jmercerr/CW312T-ESP32/KiCAD_Test3.kicad_pcb

## KiCad design KiCAD_Test3.kicad_pcb (2024-12-19)

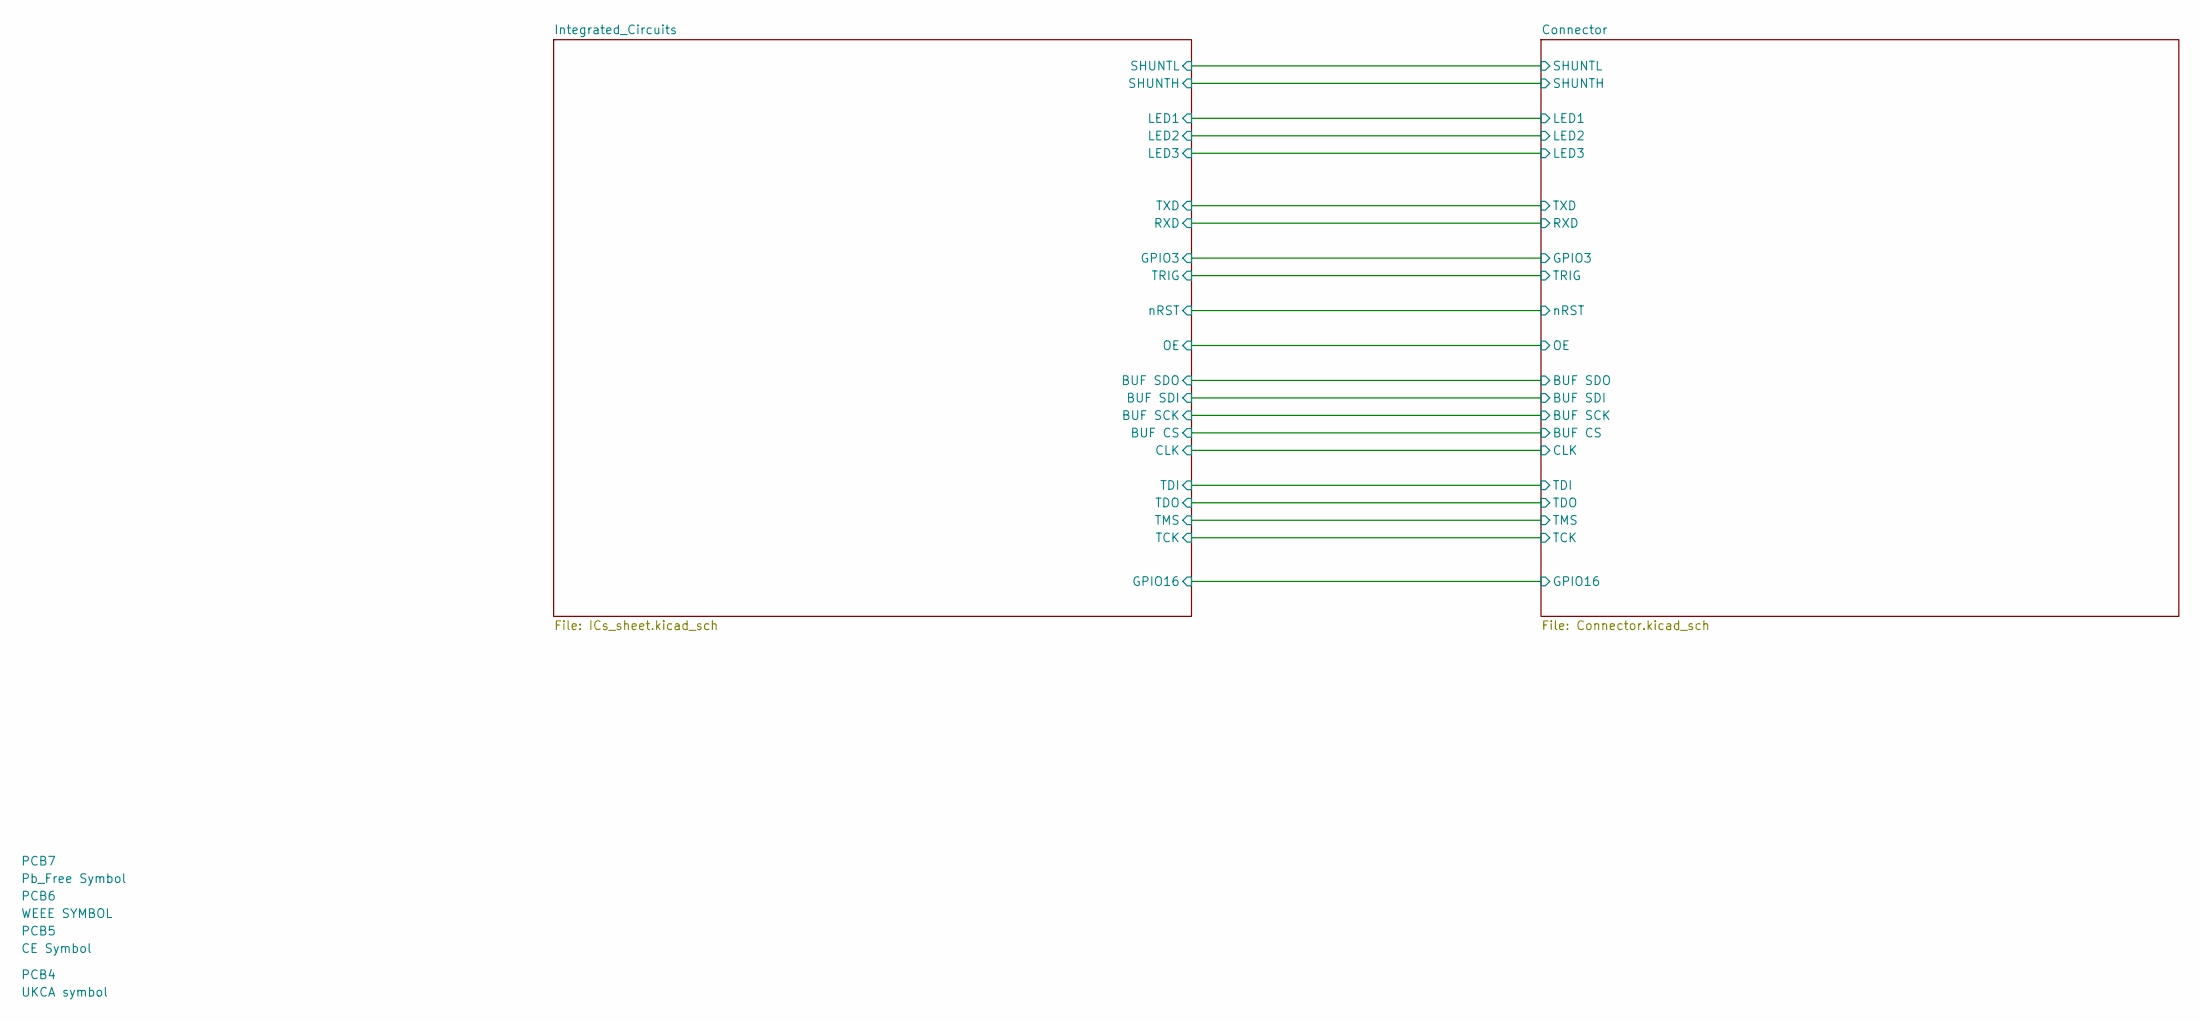
[picture p1: schematic KiCAD_Test3.kicad_sch]

Parts:
PCB4: UKCA symbol; UKCA-Logo_8x8mm_SilkScreen
PCB5: CE Symbol; CE-Logo_8.5x6mm_SilkScreen
PCB6: WEEE SYMBOL; WEEE-Logo_5.6x8mm_SilkScreen
PCB7: Pb_Free Symbol; Pb_Free_8.0x8.0mm_SilkScreen

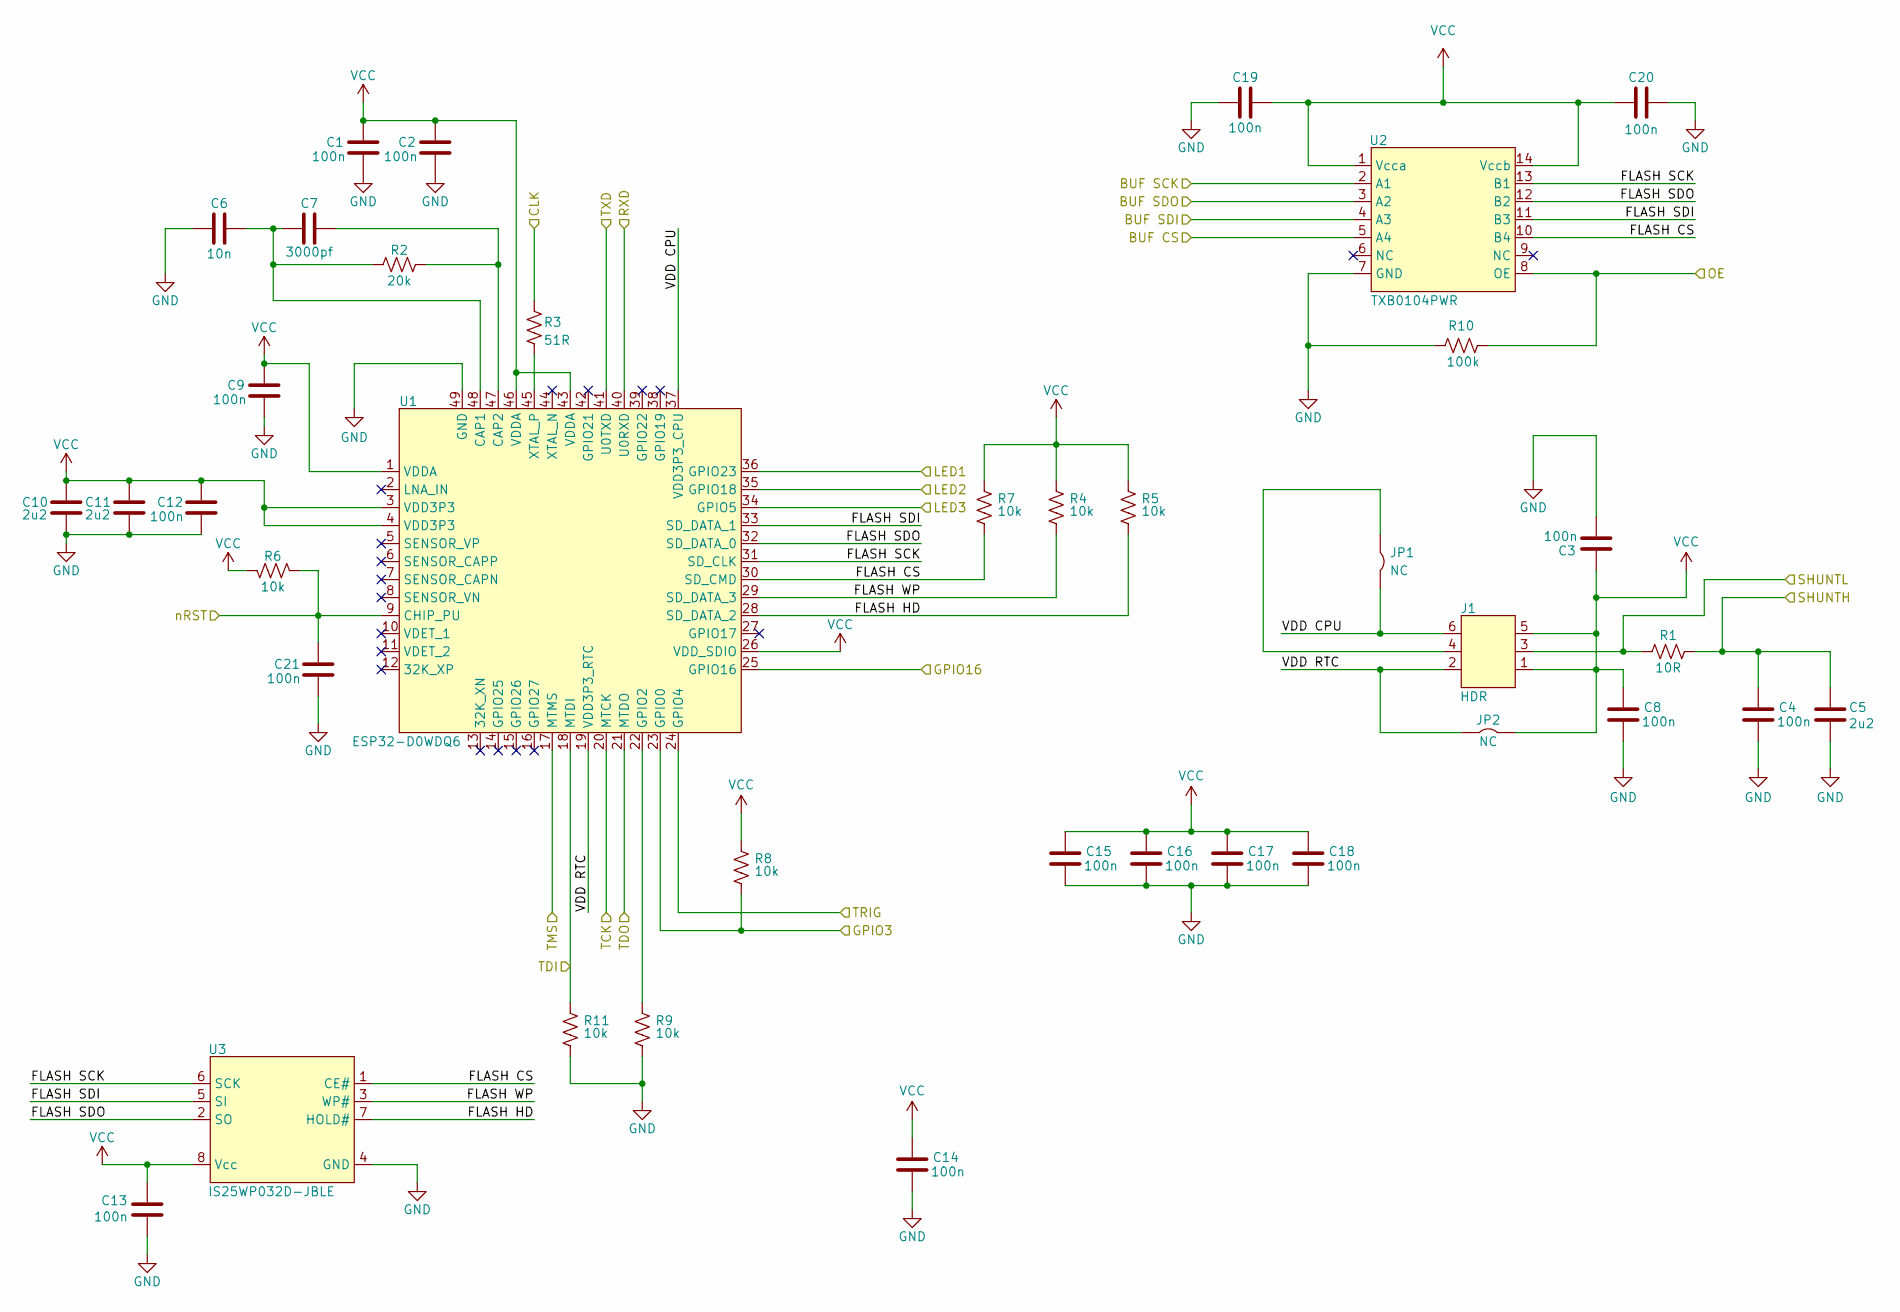
[picture p2: schematic ICs_sheet.kicad_sch]

Parts:
C1, C2, C3, C4, C8, C9, C12, C13, C14, C15, C16, C17, C18, C19, C20, C21: CAP_100n_6.3V_0603; C_0603_1608Metric; Manufacturer Part Number CC0603KRX7R5BB104
C5, C10, C11: CAP_2u2_6.3V_0603; C_0603_1608Metric; Manufacturer Part Number CC0603KRX7R5BB225
C6: CAP_10n_10V_0603; C_0603_1608Metric; Manufacturer Part Number CC0603KRX7R6BB103
C7: CAP_3000p_50V_0603; C_0603_1608Metric; Manufacturer Part Number CC0603JRNPO9BN302
J1: HDR_6_2.54; PinHeader_2x03_P2.54mm_Vertical; Manufacturer Part Number PH2-06-UA
JP1, JP2: SolderJumper-2_P1.3mm_Bridged2Bar_Pad1.0x1.5mm
R1: RES_10R_0603; R_0603_1608Metric; Manufacturer Part Number RC0603FR-0710RL
R2: RES_20k_0603; R_0603_1608Metric; Manufacturer Part Number RC0603FR-0720KL
R3: RES_51R_0603; R_0603_1608Metric; Manufacturer Part Number RC0603FR-0751RL
R4, R5, R6, R7, R8, R9, R11: RES_10k_0603; R_0603_1608Metric; Manufacturer Part Number RC0603FR-0710KL
R10: RES_100k_0603; R_0603_1608Metric; Manufacturer Part Number RC0603FR-07100KL
U1: ESP32-D0WDQ6; QFN-48-1EP_6x6mm_P0.4mm_EP4.3x4.3mm; Manufacturer Part Number ESP32-D0WDQ6
U2: TXB0104PWR; SOIC-14_3.9x8.7mm_P1.27mm; Manufacturer Part Number TXB0104PWR
U3: IS25WP032D; SOIC-8_5.275x5.275mm_P1.27mm; Manufacturer Part Number IS25WP032D-JBLE

Connections:
/Connector/BUF CS: U2.5 (A4); also elsewhere on the board
/Connector/BUF SCK: U2.2 (A1); also elsewhere on the board
/Connector/BUF SDI: U2.4 (A3); also elsewhere on the board
/Connector/BUF SDO: U2.3 (A2); also elsewhere on the board
/Connector/CLK: R3.2; also elsewhere on the board
/Connector/GPIO3: R8.1, U1.23 (GPIO0); also elsewhere on the board
/Connector/GPIO16: U1.25 (GPIO16); also elsewhere on the board
/Connector/LED1: U1.36 (GPIO23); also elsewhere on the board
/Connector/LED2: U1.35 (GPIO18); also elsewhere on the board
/Connector/LED3: U1.34 (GPIO5); also elsewhere on the board
/Connector/OE: R10.2, U2.8 (OE); also elsewhere on the board
/Connector/RXD: U1.40 (U0RXD); also elsewhere on the board
/Connector/SHUNTL: C4.1, C5.1, J1.3, R1.1, R1.2; also elsewhere on the board
/Connector/TCK: U1.20 (MTCK); also elsewhere on the board
/Connector/TDI: R11.2, U1.18 (MTDI); also elsewhere on the board
/Connector/TDO: U1.21 (MTDO); also elsewhere on the board
/Connector/TMS: U1.17 (MTMS); also elsewhere on the board
/Connector/TRIG: U1.24 (GPIO4); also elsewhere on the board
/Connector/TXD: U1.41 (U0TXD); also elsewhere on the board
/Connector/nRST: C21.1, R6.2, U1.9 (CHIP_PU); also elsewhere on the board
/Integrated_Circuits/FLASH CS: R7.1, U1.30 (SD_CMD), U2.10 (B4), U3.1 (CE#)
/Integrated_Circuits/FLASH HD: R5.1, U1.28 (SD_DATA_2), U3.7 (HOLD#)
/Integrated_Circuits/FLASH SCK: U1.31 (SD_CLK), U2.13 (B1), U3.6 (SCK)
/Integrated_Circuits/FLASH SDI: U1.33 (SD_DATA_1), U2.11 (B3), U3.5 (SI)
/Integrated_Circuits/FLASH SDO: U1.32 (SD_DATA_0), U2.12 (B2), U3.2 (SO)
/Integrated_Circuits/FLASH WP: R4.1, U1.29 (SD_DATA_3), U3.3 (WP#)
/Integrated_Circuits/VDD CPU: J1.6, JP1.1, U1.37 (VDD3P3_CPU)
/Integrated_Circuits/VDD RTC: J1.2, JP2.2, U1.19 (VDD3P3_RTC)
GND: C1.2, C2.2, C3.2, C4.2, C5.2, C6.1, C8.2, C9.2, C10.2, C11.2, C12.2, C13.2, C14.2, C15.2, C16.2, C17.2, C18.2, C19.2, C20.2, C21.2, R9.1, R10.1, R11.1, U1.49 (GND), U2.7 (GND), U3.4 (GND); also elsewhere on the board
unnamed: J1.4, JP1.2
unnamed: C6.2, C7.1, R2.1, U1.48 (CAP1)
unnamed: C7.2, R2.2, U1.47 (CAP2)
unnamed: R9.2, U1.22 (GPIO2)
unnamed: R3.1, U1.45 (XTAL_P)
VCC: C1.1, C2.1, C3.1, C8.1, C9.1, C10.1, C11.1, C12.1, C13.1, C14.1, C15.1, C16.1, C17.1, C18.1, C19.1, C20.1, J1.1, J1.5, JP2.1, R4.2, R5.2, R6.1, R7.2, R8.2, U1.1 (VDDA), U1.3 (VDD3P3), U1.4 (VDD3P3), U1.26 (VDD_SDIO), U1.43 (VDDA), U1.46 (VDDA), U2.1 (Vcca), U2.14 (Vccb), U3.8 (Vcc); also elsewhere on the board

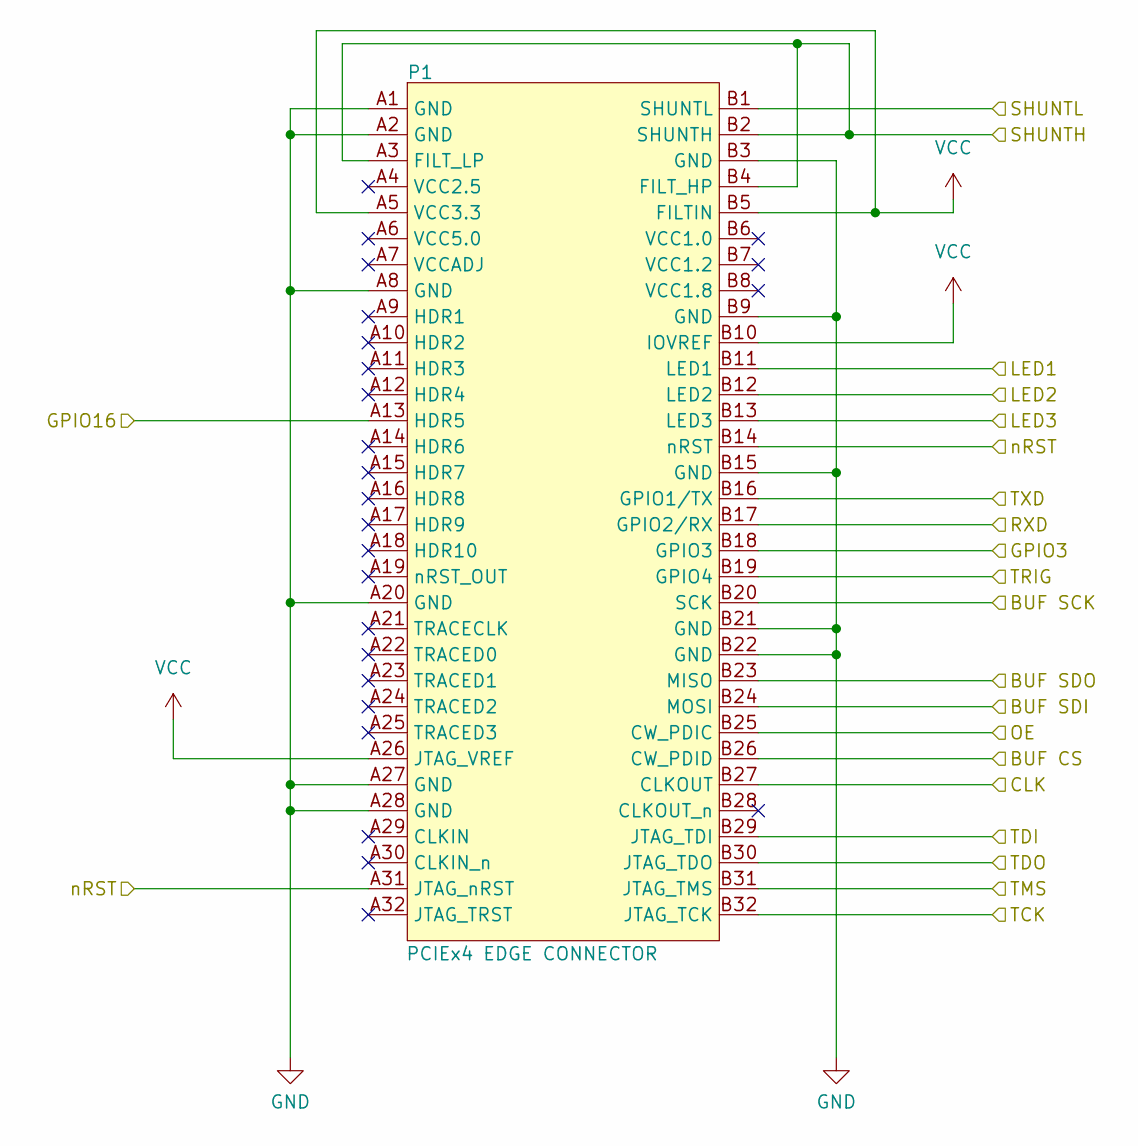
[picture p3: schematic Connector.kicad_sch]

Parts:
P1: PCIEx4 EDGE CONNECTOR; CW312_Template

Connections:
/Connector/BUF CS: P1.B26 (CW_PDID); also elsewhere on the board
/Connector/BUF SCK: P1.B20 (SCK); also elsewhere on the board
/Connector/BUF SDI: P1.B24 (MOSI); also elsewhere on the board
/Connector/BUF SDO: P1.B23 (MISO); also elsewhere on the board
/Connector/CLK: P1.B27 (CLKOUT); also elsewhere on the board
/Connector/GPIO3: P1.B18 (GPIO3); also elsewhere on the board
/Connector/GPIO16: P1.A13 (HDR5); also elsewhere on the board
/Connector/LED1: P1.B11 (LED1); also elsewhere on the board
/Connector/LED2: P1.B12 (LED2); also elsewhere on the board
/Connector/LED3: P1.B13 (LED3); also elsewhere on the board
/Connector/OE: P1.B25 (CW_PDIC); also elsewhere on the board
/Connector/RXD: P1.B17 (GPIO2/RX); also elsewhere on the board
/Connector/SHUNTL: P1.A3 (FILT_LP), P1.B1 (SHUNTL), P1.B2 (SHUNTH), P1.B4 (FILT_HP); also elsewhere on the board
/Connector/TCK: P1.B32 (JTAG_TCK); also elsewhere on the board
/Connector/TDI: P1.B29 (JTAG_TDI); also elsewhere on the board
/Connector/TDO: P1.B30 (JTAG_TDO); also elsewhere on the board
/Connector/TMS: P1.B31 (JTAG_TMS); also elsewhere on the board
/Connector/TRIG: P1.B19 (GPIO4); also elsewhere on the board
/Connector/TXD: P1.B16 (GPIO1/TX); also elsewhere on the board
/Connector/nRST: P1.A31 (JTAG_nRST), P1.B14 (nRST); also elsewhere on the board
GND: P1.A1 (GND), P1.A2 (GND), P1.A8 (GND), P1.A20 (GND), P1.A27 (GND), P1.A28 (GND), P1.B3 (GND), P1.B9 (GND), P1.B15 (GND), P1.B21 (GND), P1.B22 (GND); also elsewhere on the board
VCC: P1.A5 (VCC3.3), P1.A26 (JTAG_VREF), P1.B5 (FILTIN), P1.B10 (IOVREF); also elsewhere on the board

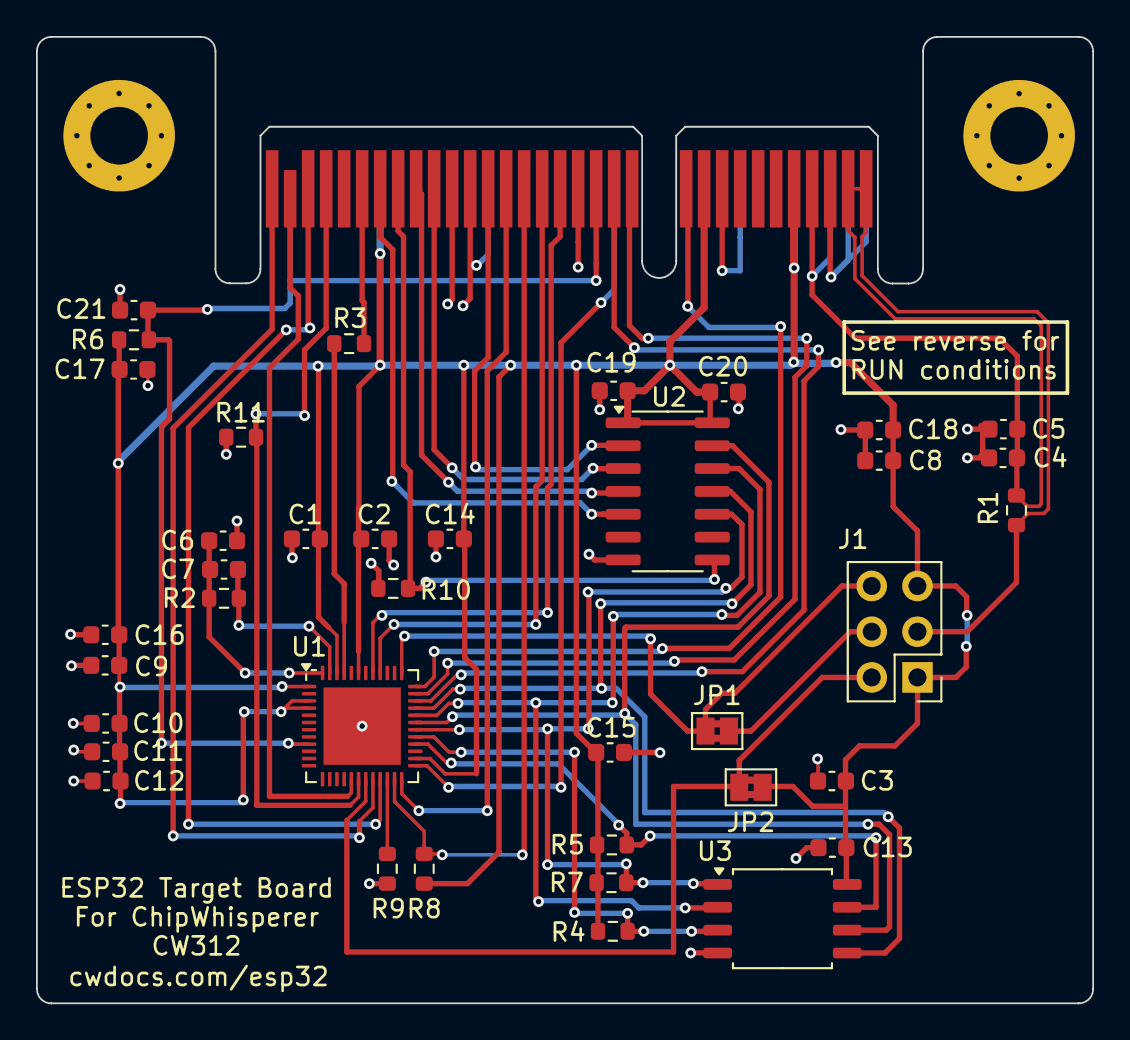
[picture p4: board KiCAD_Test3.kicad_pcb from above]

Board: 2 copper layers, 58.7 x 53.7 mm, 43 parts (0 on the bottom side), 35 nets.
