jmercerr/CW312T-ESP32/(commit log)

2024-11-08 initial commit of KiCAD files for ESP32 Target
    [KiCAD_Test3.kicad_pcb, KiCAD_Test3.kicad_sch, Sheet_1.kicad_sch, Sheet_2.kicad_sch, untitled.kicad_sch]
2024-11-15 updated ESP32 design - needs silkscreen added and shunt should be moved to be closer to U1
    [Connector.kicad_sch, ICs_sheet.kicad_sch, KiCAD_Test3.kicad_pcb, KiCAD_Test3.kicad_sch]
2024-11-15 updated design for esp32
    [KiCAD_Test3.kicad_pcb, KiCAD_Test3.kicad_sch]
2024-11-21 updated design - removed visible pin numbers from passives, fixed connections, updated silkscreen
    [ICs_sheet.kicad_sch, KiCAD_Test3.kicad_pcb, KiCAD_Test3.kicad_sch]
2024-11-22 updated cw312T template and production files
    [KiCAD_Test3.kicad_pcb]
2024-12-19 updated pcb and schematic after library re-organization, also updated header to the correct footprint
    [Connector.kicad_sch, ICs_sheet.kicad_sch, KiCAD_Test3.kicad_pcb]
